myriadrf/vivaldi-antenna/README.md

# Vivaldi antenna for 5.5GHz and 10GHz

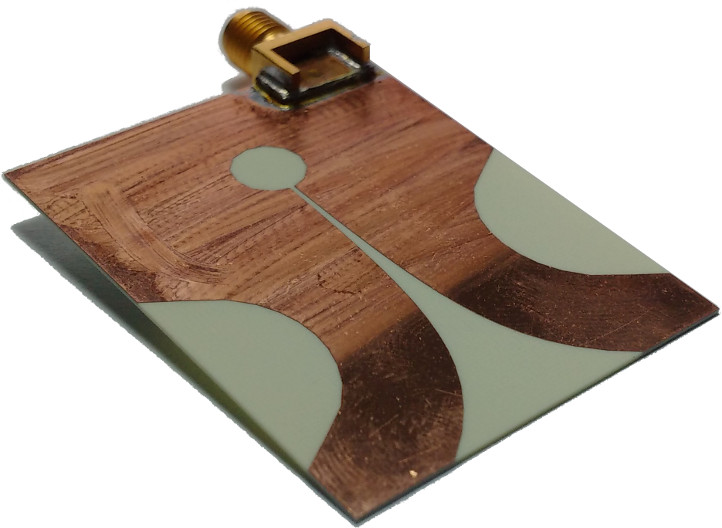
[picture p1: images/vivaldi_722w.jpg]
Vivaldi antenna


The design, together with simulation and preliminary measurement results, for a wideband Vivaldi (tapered slot) antenna.
