myriadrf/vivaldi-antenna/hardware/BOM/Vivaldi.xls

Vivaldi
Component | QTY | Reference | Footprint | Supplier | Supplier Part Number | Manufacturer | Manu Part Number | Description | Assemble | Comment
SMA_H | 1 | J1 | SMA_H | Digi-Key | J658-ND | Emerson Network Power Connectivity Johnson | 142-0701-851 | CONN, SMA, JACK, 50 OHM, EDGE MNT,
